davvdf/SRAM_precharge_access/analog/build/schematic/spice/power.spice

** sch_path: /home/david/Documents/SRAM_precharge_access/analog/schematics/power.sch
**.subckt power BL BL_N clk
*.iopin BL
*.iopin BL_N
*.ipin clk
XM1 BL clk VDD_div2 GND sky130_fd_pr__nfet_01v8 L=0.15 W=5 nf=1 ad='int((nf+1)/2) * W/nf * 0.29' as='int((nf+2)/2) * W/nf * 0.29' pd='2*int((nf+1)/2) * (W/nf + 0.29)'
+ ps='2*int((nf+2)/2) * (W/nf + 0.29)' nrd='0.29 / W' nrs='0.29 / W' sa=0 sb=0 sd=0 mult=1 m=1
XM2 BL_N clk VDD_div2 GND sky130_fd_pr__nfet_01v8 L=0.15 W=5 nf=1 ad='int((nf+1)/2) * W/nf * 0.29' as='int((nf+2)/2) * W/nf * 0.29'
+ pd='2*int((nf+1)/2) * (W/nf + 0.29)' ps='2*int((nf+2)/2) * (W/nf + 0.29)' nrd='0.29 / W' nrs='0.29 / W' sa=0 sb=0 sd=0 mult=1 m=1
XM3 BL clk BL_N GND sky130_fd_pr__nfet_01v8 L=0.15 W=10 nf=1 ad='int((nf+1)/2) * W/nf * 0.29' as='int((nf+2)/2) * W/nf * 0.29' pd='2*int((nf+1)/2) * (W/nf + 0.29)'
+ ps='2*int((nf+2)/2) * (W/nf + 0.29)' nrd='0.29 / W' nrs='0.29 / W' sa=0 sb=0 sd=0 mult=1 m=1
V2 VDD_div2 GND 0.9
V4 clk GND PULSE(0 1.8 0n 0.2n 0.2n 7.575n 15.15n)
**** begin user architecture code

.ic V(BL)=1.8 V(BL_N)=0
.tran 100p 30n


.param mc_mm_switch=0
.param mc_pr_switch=0
.include /home/david/.volare/sky130A/libs.tech/ngspice/corners/tt.spice
.include /home/david/.volare/sky130A/libs.tech/ngspice/r+c/res_typical__cap_typical.spice
.include /home/david/.volare/sky130A/libs.tech/ngspice/r+c/res_typical__cap_typical__lin.spice
.include /home/david/.volare/sky130A/libs.tech/ngspice/corners/tt/specialized_cells.spice

**** end user architecture code
**.ends
.GLOBAL GND
.end
