davvdf/SRAM_precharge_access/analog/build/schematic/spice/sweep.spice

** sch_path: /home/david/Documents/SRAM_precharge_access/analog/schematics/sweep.sch
**.subckt sweep
XM1 INV INV_N GND GND sky130_fd_pr__nfet_01v8 L=0.25 W=0.75 nf=1 ad='int((nf+1)/2) * W/nf * 0.29' as='int((nf+2)/2) * W/nf * 0.29'
+ pd='2*int((nf+1)/2) * (W/nf + 0.29)' ps='2*int((nf+2)/2) * (W/nf + 0.29)' nrd='0.29 / W' nrs='0.29 / W' sa=0 sb=0 sd=0 mult=1 m=1
R1 VDD INV_N 50k m=1
R2 VDD INV 50k m=1
XM3 INV_N WL BL_N GND sky130_fd_pr__nfet_01v8 L=0.3 W=0.42 nf=1 ad='int((nf+1)/2) * W/nf * 0.29' as='int((nf+2)/2) * W/nf * 0.29' pd='2*int((nf+1)/2) * (W/nf + 0.29)'
+ ps='2*int((nf+2)/2) * (W/nf + 0.29)' nrd='0.29 / W' nrs='0.29 / W' sa=0 sb=0 sd=0 mult=1 m=1
XM4 INV WL BL GND sky130_fd_pr__nfet_01v8 L=0.3 W=0.42 nf=1 ad='int((nf+1)/2) * W/nf * 0.29' as='int((nf+2)/2) * W/nf * 0.29' pd='2*int((nf+1)/2) * (W/nf + 0.29)'
+ ps='2*int((nf+2)/2) * (W/nf + 0.29)' nrd='0.29 / W' nrs='0.29 / W' sa=0 sb=0 sd=0 mult=1 m=1
XM2 INV_N net1 GND GND sky130_fd_pr__nfet_01v8 L=0.25 W=0.75 nf=1 ad='int((nf+1)/2) * W/nf * 0.29' as='int((nf+2)/2) * W/nf * 0.29'
+ pd='2*int((nf+1)/2) * (W/nf + 0.29)' ps='2*int((nf+2)/2) * (W/nf + 0.29)' nrd='0.29 / W' nrs='0.29 / W' sa=0 sb=0 sd=0 mult=1 m=1
V1 VDD GND 1.8
V3 WL GND 0
Vsweep net1 INV 0
**** begin user architecture code

.ic V(INV_N)=1.8 V(INV)=0
.dc Vsweep 0 1.8 0.01


.param mc_mm_switch=1
.param mc_pr_switch=0
.include /home/david/.volare/sky130A/libs.tech/ngspice/corners/ff.spice
.include /home/david/.volare/sky130A/libs.tech/ngspice/r+c/res_typical__cap_typical.spice
.include /home/david/.volare/sky130A/libs.tech/ngspice/r+c/res_typical__cap_typical__lin.spice
.include /home/david/.volare/sky130A/libs.tech/ngspice/corners/ff/specialized_cells.spice

**** end user architecture code
**.ends
.GLOBAL VDD
.GLOBAL GND
.end
