davvdf/SRAM_precharge_access/(commit log)

2025-10-01 placed nmos
    [SRAM_precharge.sch]
2025-10-27 precharge and access circuits created
    [SRAM_access.sch, SRAM_precharge.sch]
2025-10-29 2T and 4T variants symbols and schematics
    [2T2R.sch, 4T.sch, Access_2T2R.sch, Access_4T.sch, SRAM_access.sch, tb.sch]
2025-10-29 tb skeleton and precharge sym
    [SRAM_precharge.sch, tb.sch]
2025-11-05 precharge tb
    [SRAM_precharge.sch, precharge_tb.sch]
2025-11-05 smal chagnes
    [SRAM_precharge.sch]
2025-11-11 tb for transmission gate
    [SRAM_precharge.sch, precharge_trans_gate.sch, trans_gate_tb.sch]
2025-11-11 tested capacitor sweep and noise analysis
    [Access_tb.sch, SRAM_precharge.sch, precharge_trans_gate.sch, tb.sch, trans_gate_tb.sch]
2025-11-11 quick fixes
    [precharge_trans_gate.sch, trans_gate_tb.sch]
2025-11-11 corner analysis
    [precharge_trans_gate.sch, tb.sch, trans_gate_tb.sch]
2025-11-12 tested and started layout
    [precharge_trans_gate.sch, tb.sch, trans_gate_tb.sch]
2025-11-23 monte carlo and testing read
    [2T2R.sch, 4T.sch, 4T_normal.sch, 4T_trans.sch, Access_2T2R.sch, Access_4T.sch, Access_tb.sch, normal_flat.sch]
2025-11-24 generated snm for mounib
    [4T_normal.sch, normal_flat.sch, sweep.sch]
2025-12-02 implement magic circuitry
2025-12-04 readme+circuit changes
    [4T_trans.sch, normal_flat.sch, trans_gate_flat.sch]
2025-12-04 refactor circuit design documentation
2025-12-04 added power draw testing and more documentation
    [power.sch]
2025-12-04 more pictures
    [SRAM_precharge.sch]
2025-12-04 moving stuff
    [tb.sch]
